No-George/BinaryClock/Business_Card_0.1/Images/Business_Card_0.1 back.PNG

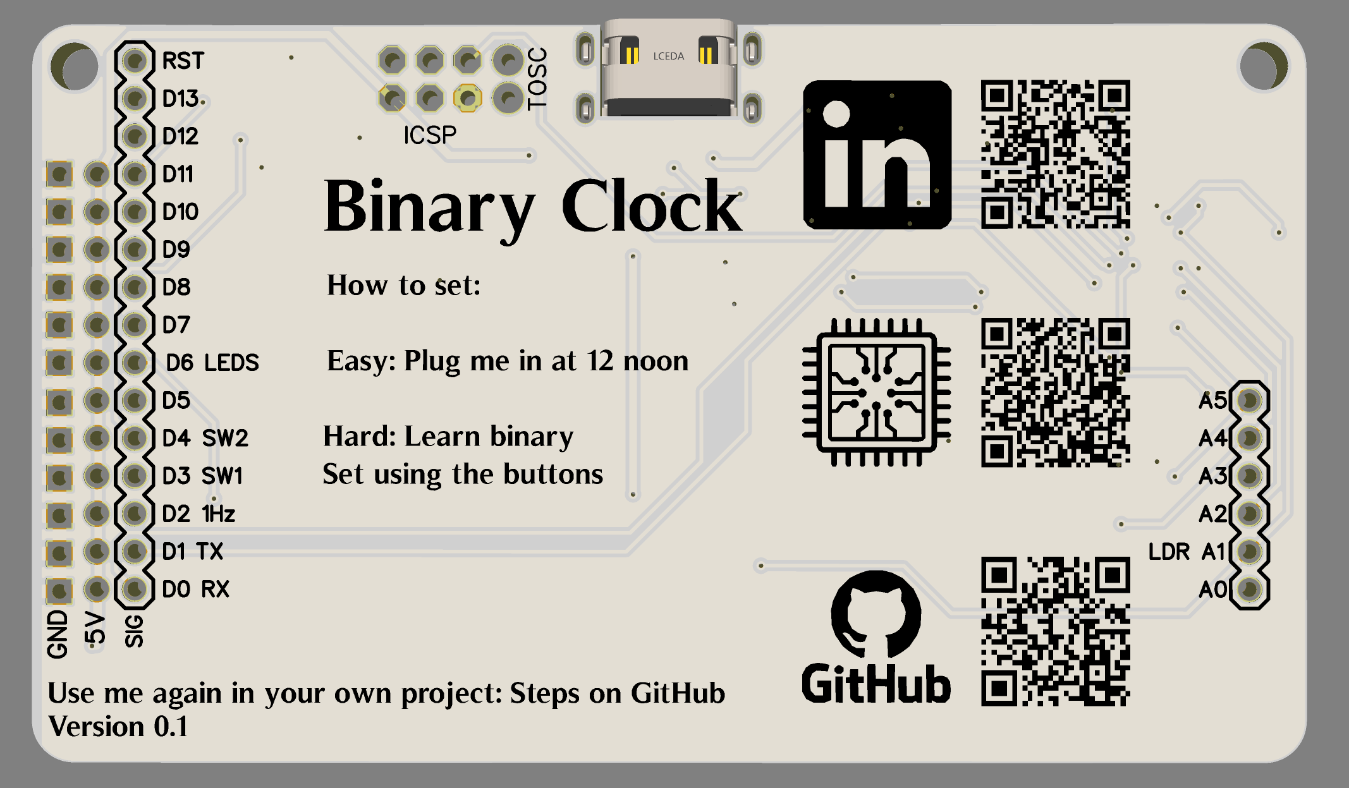
Business_Card_0.1/Images/Business_Card_0.1 back.PNG
