No-George/BinaryClock/Business_Card_0.1/Images/Business_Card_0.1 front.PNG

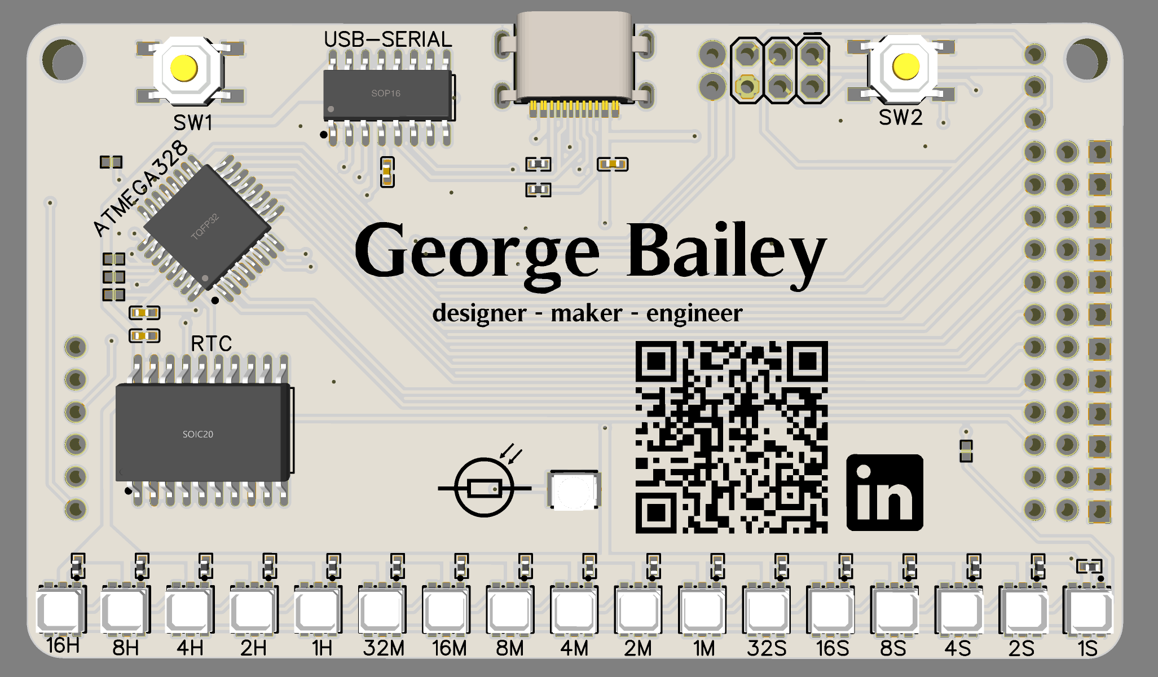
Business_Card_0.1/Images/Business_Card_0.1 front.PNG
